albert828/Sterowniki-robotow-P/README.md

# Remote control robot
> Type (1,1) robot controled by smartphone using WiFi newtork.

## Table of contents
* [General info](#general-info)
* [Technologies](#technologies)
* [Libraries](#libraries)
* [Features](#features)
* [Documentation](#documentation)
* [Status](#status)
* [Contact](#contact)
* [Contributors](#contributors)

## General info
The robot was created as university project in the subject of Robot Controllers.

## Technologies
* C
* STM32
* Arduino

## Libraries
* STM32 HAL

## Features
### Completed
- Build a remote-controlled robot.
- Smartphone gyro control.
- Stabilization of the speed of movement by PID controller and encoders
- Implementation of communication beetwen controller and WiFi module
- Implementation of communication beetwen WiFi module and smartphone
### Unrealized
- Stabilization of the speed of movement by PID controller due to the low precision of the encoders

## Documentation
[Docs](./Etap%203/SteRoP_2019_HURA_ALMM_3/SteRoP_2019_HURA_ALMM_3.pdf)

## Status
Project is: _finished_

## Contact
albert.lis.1996@gmail.com - feel free to contact me!

## Contributors
[Albert Lis](https://github.com/albertlis) [MichalMorun](https://github.com/MichalMorun)
