albert828/Sterowniki-robotow-P/Etap 2/SteRoP_2019_HURA_ALMM_2/SteRoP_2019_HURA_ALMM_2.tex

% !TeX encoding = UTF-8
% !TeX spellcheck = pl_PL

% $Id:$

%Author: Wojciech Domski
%Szablon do ząłożeń projektowych, raportu i dokumentacji z steorwników robotów
%Wersja v.1.0.0
%

%% Konfiguracja:
\newcommand{\kurs}{Sterowniki robot\'{o}w}
\newcommand{\formakursu}{Projekt}

%odkomentuj właściwy typ projektu, a pozostałe zostaw zakomentowane
%\newcommand{\doctype}{Za\l{}o\.{z}enia projektowe} %etap I
\newcommand{\doctype}{Raport} %etap II
%\newcommand{\doctype}{Dokumentacja} %etap III

%wpisz nazwę projektu
\newcommand{\projectname}{Humanistycznie upo\'sledzony robot akrobatyczny}

%wpisz akronim projektu
\newcommand{\acronim}{HURA}

%wpisz Imię i nazwisko oraz numer albumu
\newcommand{\osobaA}{Albert \textsc{Lis}, 235534}
%w przypadku projektu jednoosobowego usuń zawartość nowej komendy
\newcommand{\osobaB}{Micha\l{} \textsc{Moru\'n}, 235986}

%wpisz termin w formie, jak poniżej dzień, parzystość, godzina
\newcommand{\termin}{sr TP15 }

%wpisz imię i nazwisko prowadzącego
\newcommand{\prowadzacy}{mgr in\.{z}. Wojciech \textsc{Domski}}

\documentclass[10pt, a4paper]{article}

\include{preambula}
	
\begin{document}

\def\tablename{Tabela}	%zmienienie nazwy tabel z Tablica na Tabela

\begin{titlepage}
	\begin{center}
		\textsc{\LARGE \formakursu}\\[1cm]		
		\textsc{\Large \kurs}\\[0.5cm]		
		\rule{\textwidth}{0.08cm}\\[0.4cm]
		{\huge \bfseries \doctype}\\[1cm]
		{\huge \bfseries \projectname}\\[0.5cm]
		{\huge \bfseries \acronim}\\[0.4cm]
		\rule{\textwidth}{0.08cm}\\[1cm]
		
		\begin{flushright} \large
		\emph{Skład grupy:}\\
		\osobaA\\
		\osobaB\\[0.4cm]
		
		\emph{Termin: }\termin\\[0.4cm]

		\emph{Prowadzący:} \\
		\prowadzacy \\
		
		\end{flushright}
		
		\vfill
		
		{\large \today}
	\end{center}	
\end{titlepage}

\newpage
\tableofcontents
\newpage

%Obecne we wszystkich dokumentach
\section{Opis projektu}
\label{sec:OpisProjektu}

Celem projektu jest zbudowanie zdalnie sterowanego robota jezdnego. Robot będzie sterowany za pomocą akcelerometru w telefonie. Dane będą przesyłanie za pomocą Wi-Fi lub Bluetooth. Regulacja prędkości będzie się odbywać za pomocą regulatora PID. Dane o prędkości będą pobierane z enkoderów znajdujących się w kołach robota. Opcjonalnie robot będzie wyświetlał szczegółowe dane o swoim stanie wewnętrznym za pomocą wbudowanego w płytkę z mikrokontrolerem wyświetlacza LCD.
\newline
\newline

\begin{figure}[H]
	\centering
	
	\caption{Architektura systemu}
	\label{fig:Architektura}
\end{figure}

%Obecne we wszystkich dokumentach
\section{Konfiguracja mikrokontrolera}

\begin{figure}[H]
	\centering
	
	\caption{Konfiguracja wyjść mikrokontrolera w programie STM32CubeMX}
	\label{fig:KonfiguracjaMikrokontrolera}
\end{figure}

\newpage
\begin{figure}[H]
	\centering
	
	\caption{Konfiguracja zegarów mikrokontrolera}
	\label{fig:KonfiguracjaZegara}
\end{figure}

%Obecne we wszystkich dokumentach
\subsection{Konfiguracja pinów}

\begin{table}[H]
	\centering
	\begin{tabular}{|l|l|l|l|}
		\hline
		PIN & Tryb pracy & Funkcja/etykieta\\
		\hline
		PC14 & OSC32\_IN*	RCC\_OSC32\_IN	&\\
		PC15 & OSC32\_OUT*	RCC\_OSC32\_OUT	&\\
		PH0&  OSC\_IN*	RCC\_OSC\_IN	&\\
		PH1&  OSC\_OUT*&		RCC\_OSC\_OUT	\\
		PD5&	USART2\_TX&	USART\_TX\\
		PD6&	USART2\_RX&	USART\_RX\\
		%PE11&	TIM1\_CH2&	PWM\_SERVO\\
		PA0&	ADC1\_IN5&	PWM\_INPUT\\
		PA1&	GPIO\_Input&	JOY\_LEFT\\
		PA2&	GPIO\_Input&	JOY\_RIGHT\\
		PA3&	GPIO\_Input&	JOY\_UP\\
		PA4& GPIO\_Input& JOY\_DOWN\\
		PA5&	TIM2\_CH1&	PWM\_MOTOR\\
		PB7&    TIM4\_CH2&	PWM\_SERVO\\

		\hline
	\end{tabular}
	\caption{Konfiguracja pinów mikrokontrolera}
\end{table}

%Obecne we wszystkich dokumentach
\subsection{ADC 1}

\begin{table}[H]
	\centering
	\begin{tabular}{|l|c|} \hline
		\textbf{Parametr} & Wartość \\
		\hline
		\hline  \textbf{Resolution}&ADC 12-bit resolution  \\\hline
		\textbf{DMA Continuous Requests} & \textcolor{blue}{Enabled}\\\hline
		\textbf{Data Alignment} &  Right alignment\\
		\hline
		\textbf{Continuous Conversion Mode}& Disabled\\
		\hline
		\textbf{Channel}& Channel 5\\
		\hline
		\textbf{Sampling Time}& \textcolor{blue}{92.5 Cycles}\\
		\hline
	\end{tabular}
	\caption{Konfiguracja peryferium ADC}
	\label{tab:ADC}
\end{table}

\subsection{Timer 2}

\begin{table}[H]
	\centering
	\begin{tabular}{|l|c|} \hline
		\textbf{Parametr} & Wartość \\
		\hline
		\hline  \textbf{Clock Source}&Internal Clock  \\\hline
		\textbf{Channel1} & PWM Generation CH1\\\hline
		\textbf{Prescaler} & \textcolor{blue}{PWM\_PRESC}\\\hline
		\textbf{Counter Mode} &  Up\\
		\hline
		\textbf{Counter Period}& \textcolor{blue}{PWM\_PERIOD}\\\hline
		\textbf{Internal Clock Division}& No Division\\
		\hline
		\textbf{Mode}& PWM mode 1\\
		\hline
		\textbf{CH Polarity}& High\\
		\hline
	\end{tabular}
	\caption{Konfiguracja peryferium Timer 2}
	\label{tab:Timer2}
\end{table}

\subsection{Timer 4}

\begin{table}[H]
	\centering
	\begin{tabular}{|l|c|} \hline
		\textbf{Parametr} & Wartość \\
		\hline
		\hline  \textbf{Clock Source}&Internal Clock  \\\hline
		\textbf{Channel} & PWM Generation CH2\\\hline
		\textbf{Prescaler} & \textcolor{blue}{999}\\\hline
		\textbf{Counter Mode} &  Up\\
		\hline
		\textbf{Counter Period}& \textcolor{blue}{999}\\\hline
		\textbf{Internal Clock Division}& No Division\\
		\hline
		\textbf{Mode}& PWM mode 1\\
		\hline
		\textbf{CH Polarity}& High\\
		\hline
	\end{tabular}
	\caption{Konfiguracja peryferium Timer 4}
	\label{tab:Timer4}
\end{table}

\subsection{Timer 6}

\begin{table}[H]
	\centering
	\begin{tabular}{|l|c|} \hline
		\textbf{Parametr} & Wartość \\
		\hline
		\hline
		\textbf{Prescaler} & \textcolor{blue}{TIM6\_PRESC}\\\hline
		\textbf{Counter Mode} &  Up\\
		\hline
		\textbf{Counter Period}& \textcolor{blue}{TIM6\_PERIOD}\\\hline
		\textbf{Trigger Event Selection}& \textcolor{blue}{Update Event}\\
		\hline
	\end{tabular}
	\caption{Konfiguracja peryferium Timer 6}
	\label{tab:Timer6}
\end{table}
%Obecne w dokumencie do etapu II oraz III
%\section{Urządzenia zewnętrzne}
%\textcolor{red}{Rozdział ten powinien zawierać opis i konfigurację %wykorzystanych ukladów
%	zewnętrznych, jak np. akcelerometr.}

%Obecne w dokumencie do etapu II oraz III
\section{Projekt elektroniki}
	\subsection{Schemat elektryczny}
	\begin{figure}[H]
		\centering
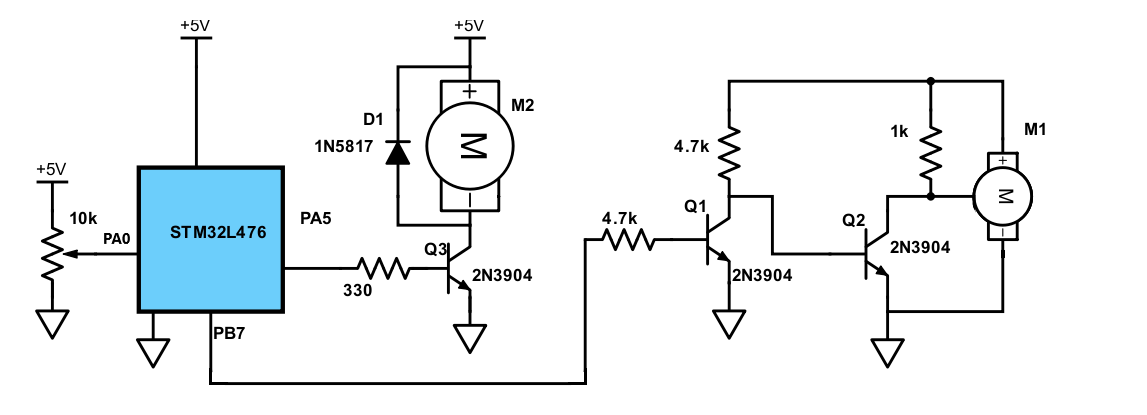
[picture p12: Etap 2/SteRoP_2019_HURA_ALMM_2/figures/schemeit-project.png]
		
		\caption{Schemat elektryczny}
		\label{fig:Schemat elektryczny}
	\end{figure}
	
\subsection{Regulacja prędkości napędu}
Za pomocą potencjometru regulujemy wypełnienie sygnału PWM. Sygnał ten jest wzmacniany za pomocą tranzystora NPN i przekazywany do silnika DC.

\begin{figure}[H]
	\centering
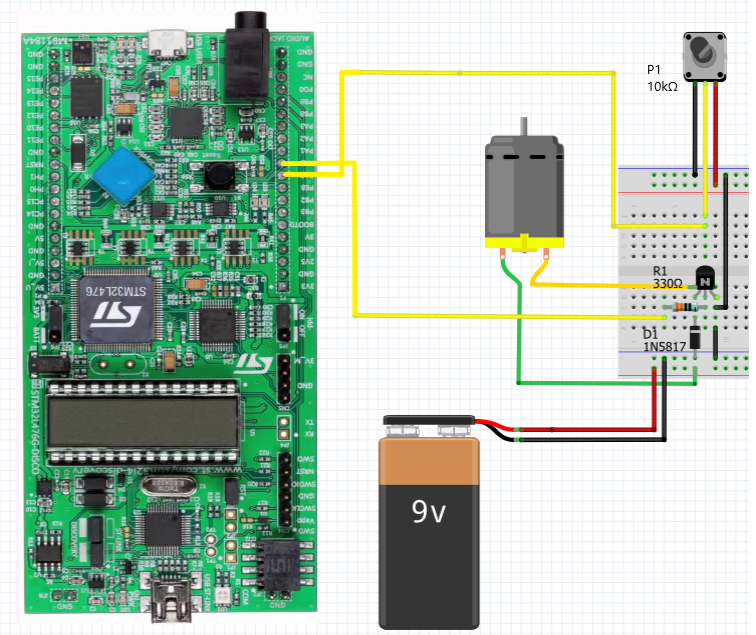
[picture p13: Etap 2/SteRoP_2019_HURA_ALMM_2/figures/pwm.png]
	
	\caption{Schemat poglądowy regulacji prędkości obrotowej silnika}
	\label{fig:KonfiguracjaPWM}
\end{figure}

%Obecne w dokumencie do etapu II oraz III
\section{Konstrukcja mechaniczna}

	\begin{figure}[H]
		\centering
		
		\caption{Zdjęcie części mechanicznej nr 1}
		\label{fig:Zdjęcie części mechanicznej nr 1}
	\end{figure}
	
		\begin{figure}[H]
		\centering
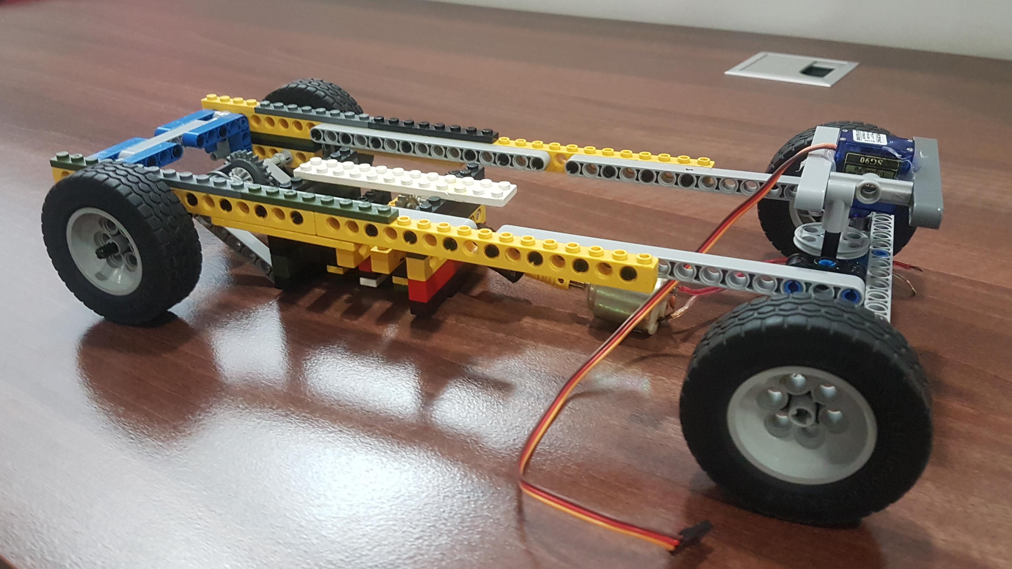
[picture p14: Etap 2/SteRoP_2019_HURA_ALMM_2/figures/20190410_135853.jpg]
		
		\caption{Zdjęcie części mechanicznej nr 2}
		\label{fig:Zdjęcie części mechanicznej nr 2}
	\end{figure}

%Obecne w dokumencie do etapu II oraz III
\section{Opis działania programu}

\subsection{Schemat działania programu}
	\begin{figure}[H]
		\centering
		
		\caption{Schemat działania programu}
		\label{fig:diagramPWM}
	\end{figure}

\subsection{Funkcja obsługująca przerwanie timera 6}
	\begin{lstlisting}[tabsize=2]
	void HAL_TIM_PeriodElapsedCallback(TIM_HandleTypeDef *htim)
	{
		if(htim->Instance == TIM6)
			HAL_ADC_Start_DMA(&hadc1, (uint32_t *)&adc_value, 1);
	}
	\end{lstlisting}

\subsection{Funkcja obsługująca przerwanie ADC}
\begin{lstlisting}[tabsize=2]
void HAL_ADC_ConvCpltCallback(ADC_HandleTypeDef* hadc)
{
	//pid_output = pid_calc(&pid, adc_value, set_value);
	__HAL_TIM_SET_COMPARE(&htim2 , TIM_CHANNEL_1, adc_value);
}
\end{lstlisting}

%Obecne w dokumencie do etapu II oraz III (jeśli coś zostało niezrealizowane)
\section{Zadania niezrealizowane}
Nie zostało zrealizowane przekazanie napędu z silnika i serwomechanizmu na mechanizm napędowy oraz na ten służący do skręcania. W pierwszym przypadku jest to spowodowane brakiem czasu, wynikający ze zbyt długim poszukiwaniem rozwiązania na problem przeniesienia napędu z silnika do przekładni, natomiast w drugim tym, że wał serwomechanizmu ma stępione zębatki co uniemożliwia przekazanie jakiejkolwiek siły na dalszy podzespół.

%Obecne we wszystkich dokumentach
\section{Podsumowanie}

Udało się zrealizować większość zadań. Nastąpiły drobne zmiany koncepcyjne jak użycie potencjometru do regulacji prędkości obrotowej napędu. To będzie wymagać mniejszej ingerencji gdy będziemy projektować regulator PID.

\newpage
\addcontentsline{toc}{section}{Bibilografia}
\bibliography{bibliografia}
\bibliographystyle{plabbrv}

\end{document}
