albert828/Sterowniki-robotow-P/Etap 3/SteRoP_2019_HURA_ALMM_3/SteRoP_2019_HURA_ALMM_3.pdf

Projekt

Sterowniki robotów

# Dokumentacja

# Humanistycznie upośledzony robot akrobatyczny

# HURA

Skład grupy:
Albert Lis, 235534
Michał Moruń, 235986

Termin: sr TP15

Prowadzący:
mgr inż. Wojciech Domski

5 czerwca 2019

## Spis treści

1 Opis projektu | 2
2 Konfiguracja mikrokontrolera | 3
3 Urządzenia zewnętrzne | 6
4 Projekt elektroniki | 7
5 Konstrukcja mechaniczna | 9
6 Regulator PID | 11
7 Opis działania programu | 11
8 Podsumowanie | 13
Bibilografia | 14

## 1 Opis projektu

Celem projektu jest zbudowanie zdalnie sterowanego robota jezdnego. Robot będzie sterowany za pomocą akcelerometru w telefonie. Dane będą przesyłanie za pomocą Wi-Fi lub Bluetooth. Regulacja prędkości będzie się odbywać za pomocą regulatora PID. Dane o prędkości będą pobierane z enkoderów znajdujących się w kołach robota. Opcjonalnie robot będzie wyświetlał szczegółowe dane o swoim stanie wewnętrznym za pomocą wbudowanego w płytkę z mikrokontrolerem wyświetlacza LCD.


Rysunek 1: Architektura systemu

## 2 Konfiguracja mikrokontrolera


Rysunek 2: Konfiguracja wyjść mikrokontrolera w programie STM32CubeMX

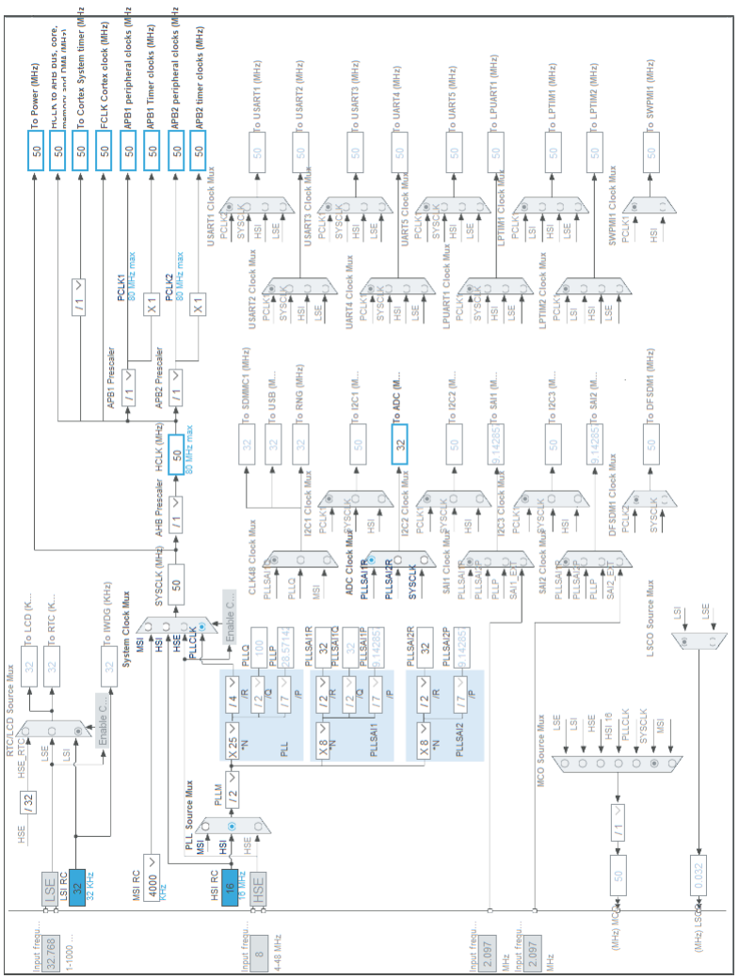
[picture p18: figure]

Rysunek 3: Konfiguracja zegarów mikrokontrolera

### 2.1 Konfiguracja pinów

PIN | Tryb pracy | Funkcja/etykieta
PC14 PC15 PH0 PH1 PA2 PA3 PA0 PA5 PB6 | OSC32_IN* RCC_OSC32_IN OSC32_OUT* RCC_OSC32_OUT OSC_IN* RCC_OSC_IN OSC_OUT* USART2_TX USART2_RX TIM5 CH1 TIM2_CH1 TIM4_CH1 | RCC_OSC_OUT USART_TX USART_RX ENCODER_P DO_PRZODU SERVO

Tabela 1: Konfiguracja pinów mikrokontrolera

### 2.2 USART

Interfejs jest wykorzystywany do komunikacji z modułem Wi-Fi (ESP8266). Moduł odbiera dane za pomocą interfejsu UDP i przekazuje je do mikrokontrolera STM32 za pomocą interfejsu komunikacji szeregowej.

Parametr | Wartość
Baud Rate | 115200
Word Length | 8 Bits (including parity)
Parity | None
Stop Bits | 1

Tabela 2: Konfiguracja peryferium USART

### 2.3 Timer 2

Parametr | Wartość
Clock Source | Internal Clock
Channel1 | PWM Generation CH1
Prescaler | TIM2_PRESC
Counter Mode | Up
Counter Period | TIM2_PERIOD
Internal Clock Division | No Division
Mode | PWM mode 1
CH Polarity | High

Tabela 3: Konfiguracja peryferium Timer 2

### 2.4 Timer 4

Parametr | Wartość
Clock Source | Internal Clock
Channel | PWM Generation CH1
Prescaler | TIM4_PRESC
Counter Mode | Up
Counter Period | TIM4_PERIOD
Internal Clock Division | No Division
Mode | PWM mode 1
CH Polarity | High

Tabela 4: Konfiguracja peryferium Timer 4

### 2.5 Timer 5

Parametr | Wartość
Clock Source | Internal Clock
Channel | Input Capture direct mode
Prescaler | TIM5_PRESC
Counter Mode | Up
Counter Period | TIM5_PERIOD
Internal Clock Division | No Division

Tabela 5: Konfiguracja peryferium Timer 6

## 3 Urządzenia zewnętrzne

### 3.1 Moduł Wi-Fi ESP8266

Moduł dobiera dane za pomocą protokołu UDP i przekazuje je odpowiednio sformatowane za pomocą portu szeregowego do mikrokontrolera STM32. Do oprogramowania modułu wykorzystano framework Arduino.
Ustawienia komunikacji szeregowej:
Parametr | Wartość
Baud Rate | 115200
Word Length | 8 Bits (including parity)
Parity | None
Stop Bits | 1

Tabela 6: Konfiguracja peryferium UART w module Wi-Fi

### 3.2 Smartfon z aplikacją RoboRemo

Przesyła wartości osi X i Y żyroskopu za pomocą protokołu UDP. Ustawienia żyroskopu w aplikacji:

Parametr | Wartość
Etykieta | x
Wzmocnienie | 1.0
Typ danych | int
Zakres | od -255 do 255
Limit do [min:max] | tak

Tabela 7: Konfiguracja osi X

Parametr | Wartość
Etykieta | y
Wzmocnienie | 0.5
Typ danych | int
Zakres | od 50 do 150
Limit do [min:max] | tak

Tabela 8: Konfiguracja osi Y

## 4 Projekt elektroniki

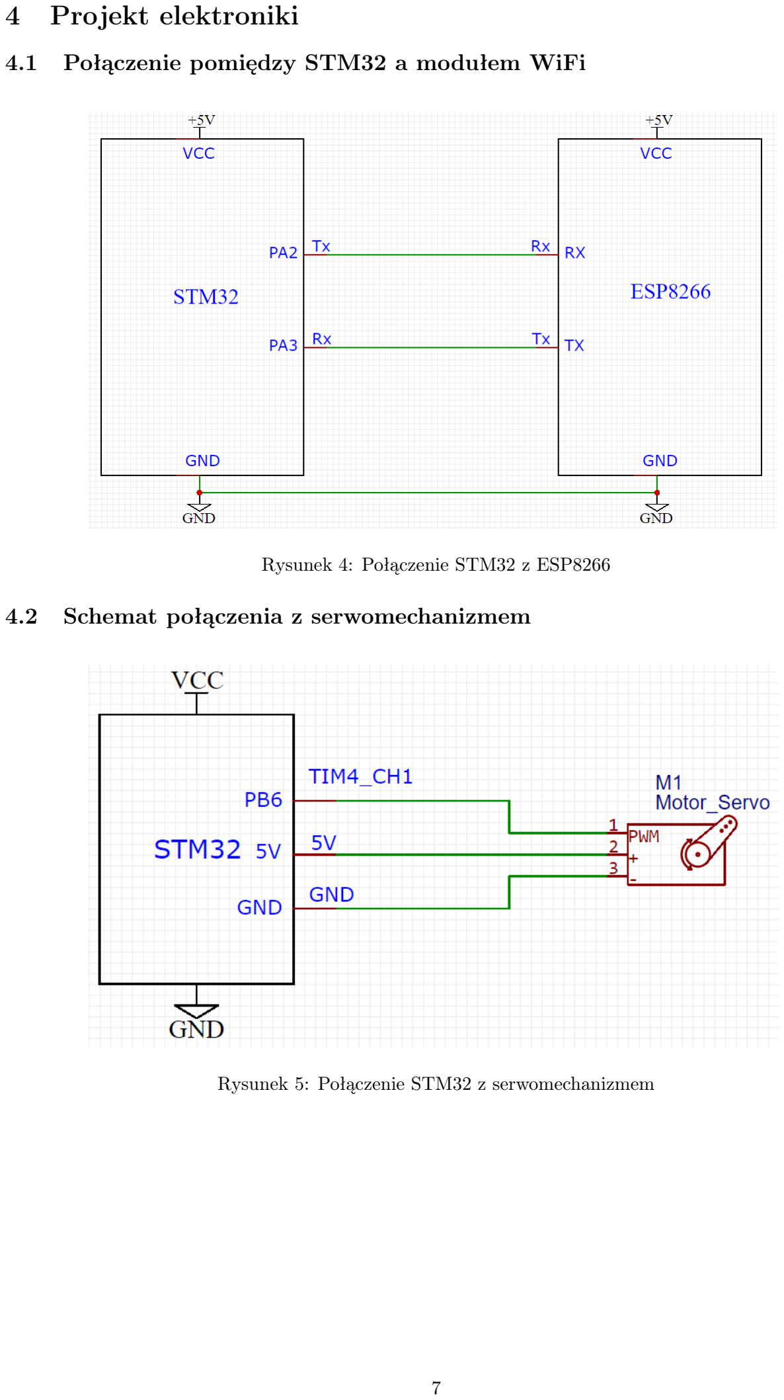
[picture p19: page 8]

### 4.1 Połączenie pomiędzy STM32 a modułem WiFi

Rysunek 4: Połączenie STM32 z ESP8266

### 4.2 Schemat połączenia z serwomechanizmem

Rysunek 5: Połączenie STM32 z serwomechanizmem

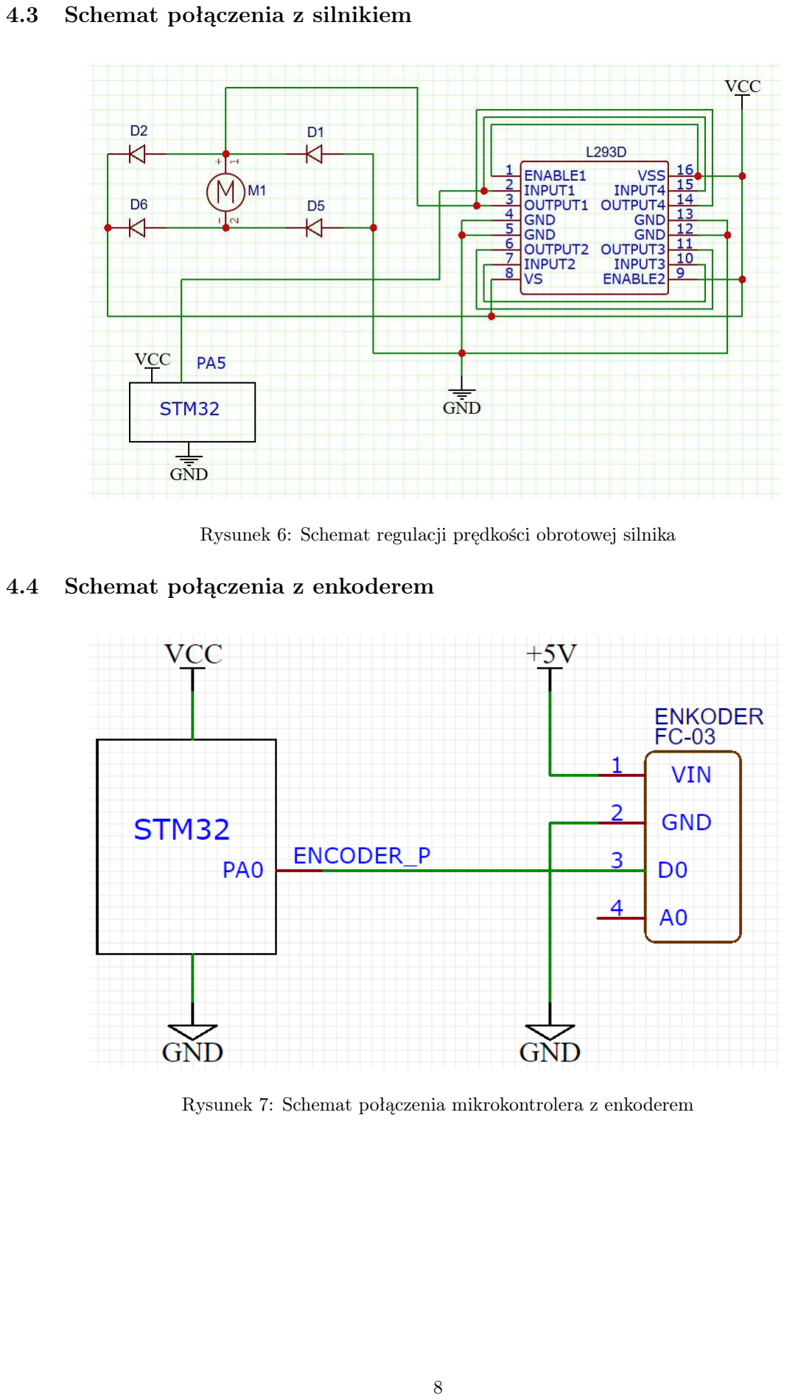
[picture p20: page 9]

### 4.3 Schemat połączenia z silnikiem

Rysunek 6: Schemat regulacji prędkości obrotowej silnika

### 4.4 Schemat połączenia z enkoderem

Rysunek 7: Schemat połączenia mikrokontrolera z enkoderem

## 5 Konstrukcja mechaniczna

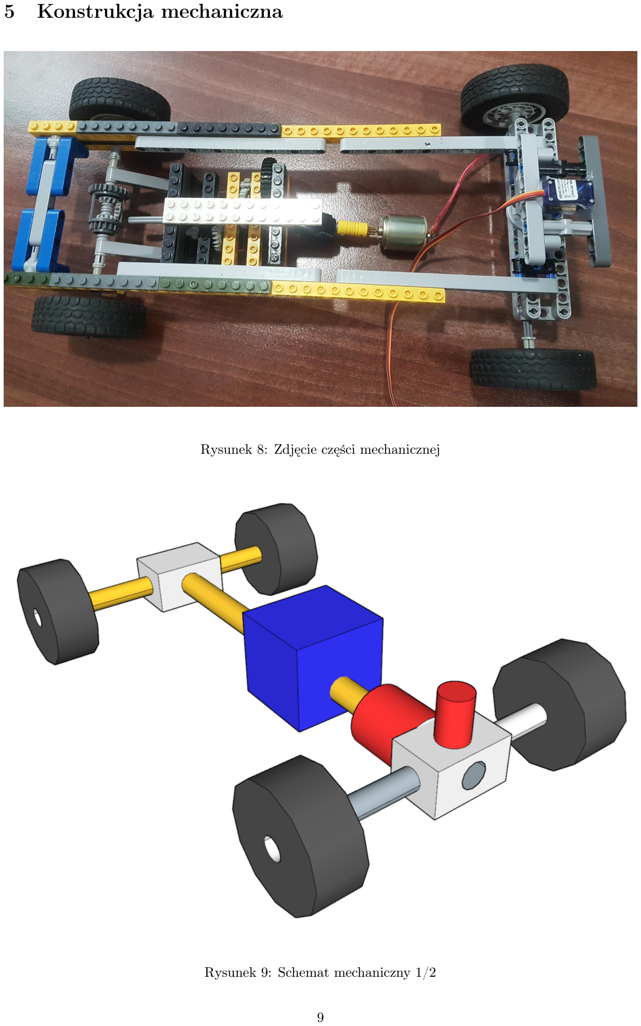
[picture p21: page 10]

Rysunek 8: Zdjęcie części mechanicznej

Rysunek 9: Schemat mechaniczny 1/2

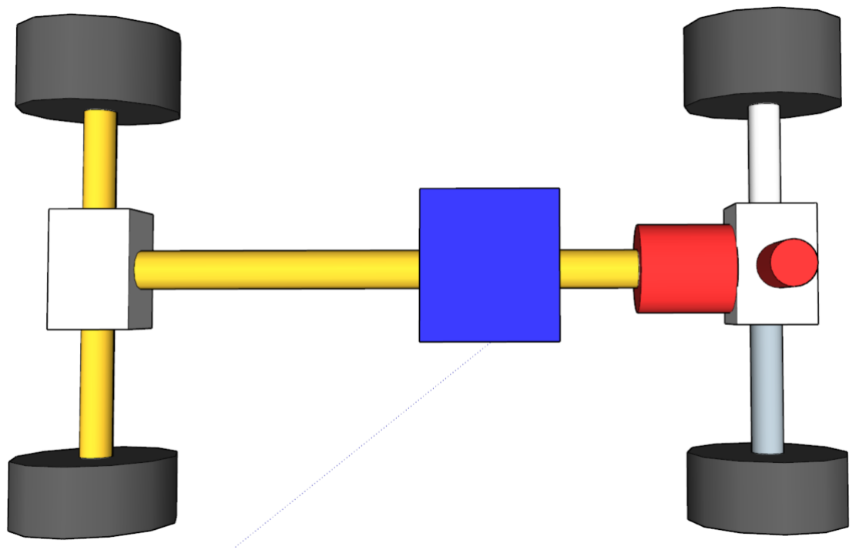
[picture p22: figure]

Rysunek 10: Schemat mechaniczny 2/2

Kolor | Opis
Czerwony | Silniki
Niebieski | Przekładnia
Żółty | Elementy przeniesienia napędu

Tabela 9: Legenda

## 6 Regulator PID

### 6.1 Wykres odpowiedzi skokowej


Rysunek 11: Odpowiedz skokowa

Na wykresie występują bardzo duże oscylacje, które są spowodowane niedoskonałością wykonanego mechanizmu różnicowego oraz zbyt małą rozdzielczością odczytów z enkoderów. W związku z tym od-powiedź skokową przybliżono linią trendu i na jej podstawie za pomocą II metody Zieglera - Nicholsa wyliczono parametry Kp, Ki oraz Kd.

### 6.2 Wyznaczenie parametrów PID

k = ∆wy/∆we =

0.01923
0.01515 = 1.2693 ≈ 1.27

Kp = 0.6 ∗ k = 0.762
Ki = 2 ∗

Kp
Pu

= 1.879
Kd =

Kp∗Pu
8 = 0.086

## 7 Opis działania programu

### 7.1 Schemat działania programu

Rysunek 12: Schemat działania programu

### 7.2 Ręczna inicjalizacja parametrów w funkcji main

1 | f l a g 1 = f l a g 2 = 0 ;
2 | pwm_dutyL = pwm_dutyP = 0 ;
3 | HAL_TIM_IC_Start_IT(&htim5 , TIM_CHANNEL_1) ;
4 | HAL_TIM_IC_Start_IT(&htim5 , TIM_CHANNEL_2) ;
5

6 | HAL_TIM_PWM_Start(&htim4 , TIM_CHANNEL_1) ;
7 | HAL_TIM_PWM_Start(&htim2 , TIM_CHANNEL_1) ;
8 | HAL_TIM_PWM_Start(&htim2 , TIM_CHANNEL_2) ;
9
10 | HAL_UART_Receive_DMA(&huart2 , &Received , BUFSIZE) ;
11 | P ID Ini t (&pid , kp , ki , kd , sampleTimeSeconds , minOutput , maxOutput , mode , c o n t r o l
| ) ;
12 | P IDSe tp oin tSe t (&pid , se t_ v alue ) ;
13 | PIDInputSet(&pid , speed ) ;

### 7.3 Funkcja obsługująca Input Capture

1 | i n t speed ;
2 | v oid HAL_TIM_IC_CaptureCallback ( TIM_HandleTypeDef ∗htim )
3 | {
4 | i f ( htim == &htim5 )
5 | {
6 | i f ( htim−>Channel == HAL_TIM_ACTIVE_CHANNEL_1)
7 | {
8 | p e ri o d 1 = __HAL_TIM_GET_COMPARE(&htim5 , TIM_CHANNEL_1) ;
9 | __HAL_TIM_SET_COUNTER(&htim5 , 0 ) ;
10 | f l a g 1 = 1 ;
11 | speed = ( p e ri o d 1 <= 5 0 ) ? ( 2 5 5 − map( pe ri od 1 , 2 0 , 5 0 , 0 , 2 5 5 ) ) : 0 ;
12 | }
13 | sampleTimeSeconds = p e ri o d 1 / 1 0 0 0 . 0 ;
14 | P ID Ini t (&pid , kp , ki , kd , sampleTimeSeconds , minOutput , maxOutput , mode ,
| c o n t r o l ) ;
15 | }
16 | }

### 7.4 Funkcja obsługująca przerwanie USART

1 | v o l a t i l e uint8_t xvalue , yvalue , y p r e vi o u s , x p r e vi o u s ;
2 | v o l a t i l e ch a r x si g n ;
3 | v oid HAL_UART_RxCpltCallback (UART_HandleTypeDef ∗ hu a r t )
4 | {
5 | a x i s = ( ch a r ) ( Received [ n rAxi s ] ) ;
6 | si g n = ( ch a r ) ( Received [ n rSi gn ] ) ;
7 | v al u e = ( uint8_t ) ( Received [ nrValue ] ) ;
8
9 | i f ( a x i s == ' x ' )
10 | {
11 | x si g n = si g n ;
12 | x p r e vi o u s = x v alue ;
13 | x v alue = v al u e ;
14 | }
15
16 | i f ( a x i s == ' y ' )
17 | {
18 | y p r e vi o u s = y v alue ;
19 | y v alue = v al u e ;
20 | i f ( abs ( v al u e − x p r e vi o u s ) < 2 )
21 | y v alue = y p r e vi o u s ;
22 | e l s e i f ( v al u e > 1 0 0 )
23 | y v alue = y p r e vi o u s ;
24 | e l s e i f ( v al u e < 5 0 )
25 | y v alue = y p r e vi o u s ;
26 | }
27 | P IDSe tp oin tSe t (&pid , se t_ v alue ) ;
28 | PIDInputSet(&pid , speed ) ;
29 | PIDCompute(& pid ) ;
30 | pid_output = PIDOutputGet(& pid ) ;
31 | HAL_UART_Receive_DMA(&huart2 , &Received , BUFSIZE) ;
32 | }

### 7.5 Funkcja realizująca jazdę

1 | v oid Jazda ( )
2 | {
3 | __HAL_TIM_SET_COMPARE(&htim2 , TIM_CHANNEL_1, 255 − pid_output ) ;
4 | }

### 7.6 Funkcja realizująca skręcanie

1 | v oid S k r e c a ni e ( )
2 | {
3 | __HAL_TIM_SET_COMPARE(&htim4 , TIM_CHANNEL_1, y v alue ) ;
4 | }

### 7.7 Funkcja mapująca wartości czasowe na wartość zadaną regulatora PID

1 | l o n g map( l o n g x , l o n g in_min , l o n g in_max , l o n g out_min , l o n g out_max )
2 | {
3 | r e t u r n ( x − in_min ) ∗ ( out_max − out_min ) / (in_max − in_min ) + out_min ;
4 | }

### 7.8 Funkcja przekierowująca printf()

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

### 7.9 Pętla główna

1 | w hil e ( 1 )
2 | {
3 | Jazda ( ) ;
4 | S k r e c a ni e ( ) ;
5 | }

## 8 Podsumowanie

| Udało się zrealizować wszystkie założenia projektowe. Jedynym elementem w projekcie, który mógłby
| być lepszy to kółko szczerbinkowe na osi o większej ilości dziurek, aby zwiększyć rozdzielczość odczytów
| z enkoderów przez co działanie regulatora PID byłoby bardziej płynne i dokładne.

## Literatura

[1] Krzysztof Amborski, Andrzej Murusak: Teoria sterowania w ćwiczeniach, (’78)
[2] Józef Lisowski: Podstawy automatyki, (2015)
[3] Jerzy Brzózka: Regulatory i układy automatyki, (2004)
[4] Krzysztof Tchoń: Manipulatory i roboty mobilne : modele, planowanie ruchu, sterowanie, (2000)
[5] Stanisław Wszelak: Administrowanie sieciowymi protokołami komunikacyjnymi, (2015)
