albert828/Sterowniki-robotow-P/Etap 2/SteRoP_2019_HURA_ALMM_2/Sterowniki_robotow_P.pdf

Projekt

Sterowniki robotów

# Raport

# Humanistycznie upośledzony robot akrobatyczny

# HURA

Skład grupy:
Albert Lis, 235534
Michał Moruń, 235986

Termin: sr TP15

Prowadzący:
mgr inż. Wojciech Domski

10 kwietnia 2019

## Spis treści

1 Opis projektu | 2
2 Konfiguracja mikrokontrolera | 3
3 Projekt elektroniki | 6
4 Konstrukcja mechaniczna | 7
5 Opis działania programu | 8
6 Zadania niezrealizowane | 8
7 Podsumowanie | 9
Bibilografia | 10

## 1 Opis projektu

Celem projektu jest zbudowanie zdalnie sterowanego robota jezdnego. Robot będzie sterowany za pomocą akcelerometru w telefonie. Dane będą przesyłanie za pomocą Wi-Fi lub Bluetooth. Regulacja prędkości będzie się odbywać za pomocą regulatora PID. Dane o prędkości będą pobierane z enkoderów znajdujących się w kołach robota. Opcjonalnie robot będzie wyświetlał szczegółowe dane o swoim stanie wewnętrznym za pomocą wbudowanego w płytkę z mikrokontrolerem wyświetlacza LCD.


Rysunek 1: Architektura systemu

## 2 Konfiguracja mikrokontrolera


Rysunek 2: Konfiguracja wyjść mikrokontrolera w programie STM32CubeMX


Rysunek 3: Konfiguracja zegarów mikrokontrolera

### 2.1 Konfiguracja pinów

PIN | Tryb pracy | Funkcja/etykieta
PC14 PC15 PH0 PH1 PD5 PD6 PA0 PA1 PA2 PA3 PA4 PA5 PB7 | OSC32_IN* RCC_OSC32_IN OSC32_OUT* RCC_OSC32_OUT OSC_IN* RCC_OSC_IN OSC_OUT* USART2_TX USART2_RX ADC1_IN5 GPIO_Input GPIO_Input GPIO_Input GPIO_Input TIM2_CH1 TIM4_CH2 | RCC_OSC_OUT USART_TX USART_RX PWM_INPUT JOY_LEFT JOY_RIGHT JOY_UP JOY_DOWN PWM_MOTOR PWM_SERVO

Tabela 1: Konfiguracja pinów mikrokontrolera

### 2.2 ADC 1

Parametr | Wartość
Resolution | ADC 12-bit resolution
DMA Continuous Requests | Enabled
Data Alignment | Right alignment
Continuous Conversion Mode | Disabled
Channel | Channel 5
Sampling Time | 92.5 Cycles

Tabela 2: Konfiguracja peryferium ADC

### 2.3 Timer 2

Parametr | Wartość
Clock Source | Internal Clock
Channel1 | PWM Generation CH1
Prescaler | PWM_PRESC
Counter Mode | Up
Counter Period | PWM_PERIOD
Internal Clock Division | No Division
Mode | PWM mode 1
CH Polarity | High

Tabela 3: Konfiguracja peryferium Timer 2

### 2.4 Timer 4

Parametr | Wartość
Clock Source | Internal Clock
Channel | PWM Generation CH2
Prescaler | 999
Counter Mode | Up
Counter Period | 999
Internal Clock Division | No Division
Mode | PWM mode 1
CH Polarity | High

Tabela 4: Konfiguracja peryferium Timer 4

### 2.5 Timer 6

Parametr | Wartość
Prescaler | TIM6_PRESC
Counter Mode | Up
Counter Period | TIM6_PERIOD
Trigger Event Selection | Update Event

Tabela 5: Konfiguracja peryferium Timer 6

## 3 Projekt elektroniki

### 3.1 Schemat elektryczny

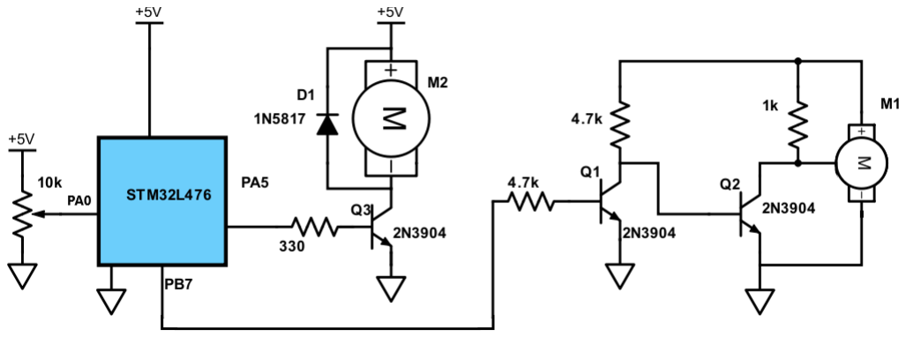
[picture p23: figure]

Rysunek 4: Schemat elektryczny

### 3.2 Regulacja prędkości napędu

Za pomocą potencjometru regulujemy wypełnienie sygnału PWM. Sygnał ten jest wzmacniany za pomocą tranzystora NPN i przekazywany do silnika DC.

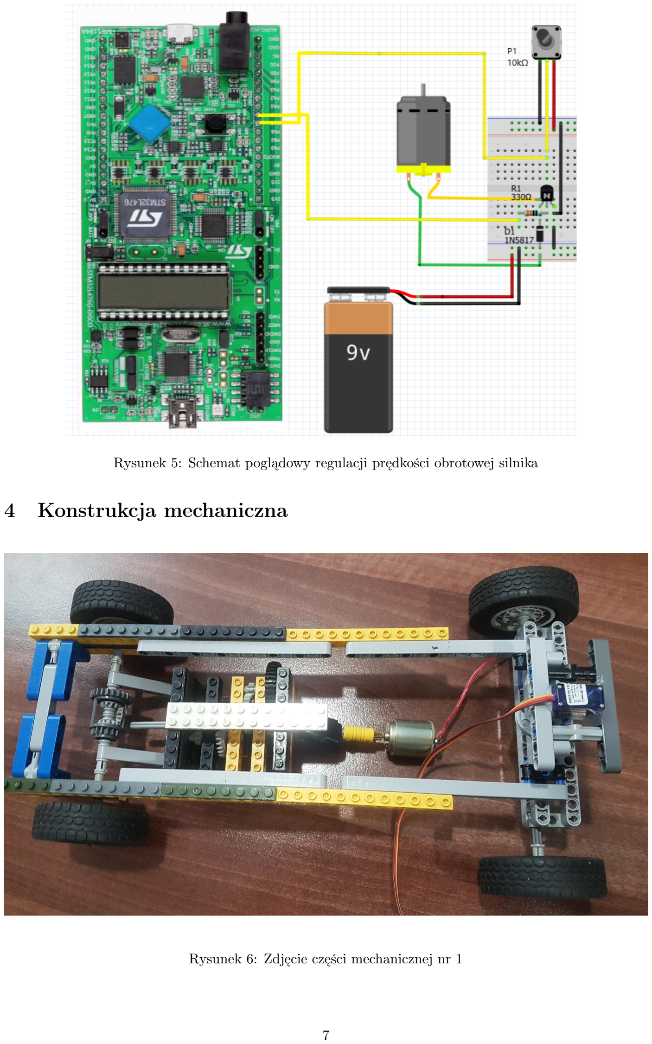
[picture p24: page 8]

Rysunek 5: Schemat poglądowy regulacji prędkości obrotowej silnika

## 4 Konstrukcja mechaniczna

Rysunek 6: Zdjęcie części mechanicznej nr 1


Rysunek 7: Zdjęcie części mechanicznej nr 2

## 5 Opis działania programu

### 5.1 Schemat działania programu

Rysunek 8: Schemat działania programu

### 5.2 Funkcja obsługująca przerwanie timera 6

1 | v oid HAL_TIM_PeriodElapsedCallback ( TIM_HandleTypeDef ∗htim )
2 | {
3 | i f ( htim−>I n s t a n c e == TIM6)
4 | HAL_ADC_Start_DMA(&hadc1 , ( uint32_t ∗)&adc_value , 1 ) ;
5 | }

### 5.3 Funkcja obsługująca przerwanie ADC

1 | v oid HAL_ADC_ConvCpltCallback (ADC_HandleTypeDef∗ hadc )
2 | {
3 | // pid_output = pid_c alc (&pid , adc_value , se t_ v alue ) ;
4 | __HAL_TIM_SET_COMPARE(&htim2 , TIM_CHANNEL_1, adc_value ) ;
5 | }

## 6 Zadania niezrealizowane

| Nie zostało zrealizowane przekazanie napędu z silnika i serwomechanizmu na mechanizm napędowy
| oraz na ten służący do skręcania. W pierwszym przypadku jest to spowodowane brakiem czasu, wynika-
| jący ze zbyt długim poszukiwaniem rozwiązania na problem przeniesienia napędu z silnika do przekładni,
| natomiast w drugim tym, że wał serwomechanizmu ma stępione zębatki co uniemożliwia przekazanie
| jakiejkolwiek siły na dalszy podzespół.

## 7 Podsumowanie

Udało się zrealizować większość zadań. Nastąpiły drobne zmiany koncepcyjne jak użycie potencjometru do regulacji prędkości obrotowej napędu. To będzie wymagać mniejszej ingerencji gdy będziemy projektować regulator PID.

## Literatura
