albert828/Sterowniki-robotow-P/Etap 3/SteRoP_2019_HURA_ALMM_3/figures/3.png

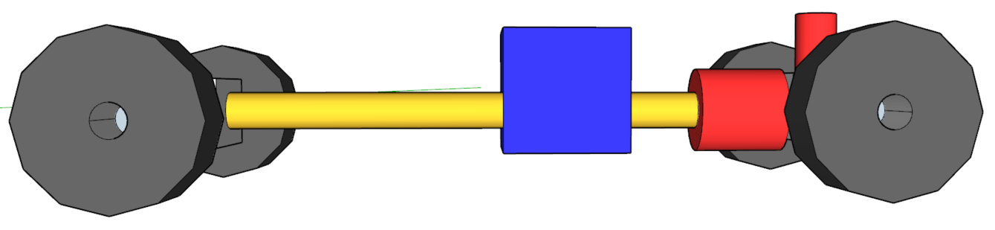
Etap 3/SteRoP_2019_HURA_ALMM_3/figures/3.png
