albert828/Sterowniki-robotow-P/Etap 3/SteRoP_2019_HURA_ALMM_3/figures/piny.png

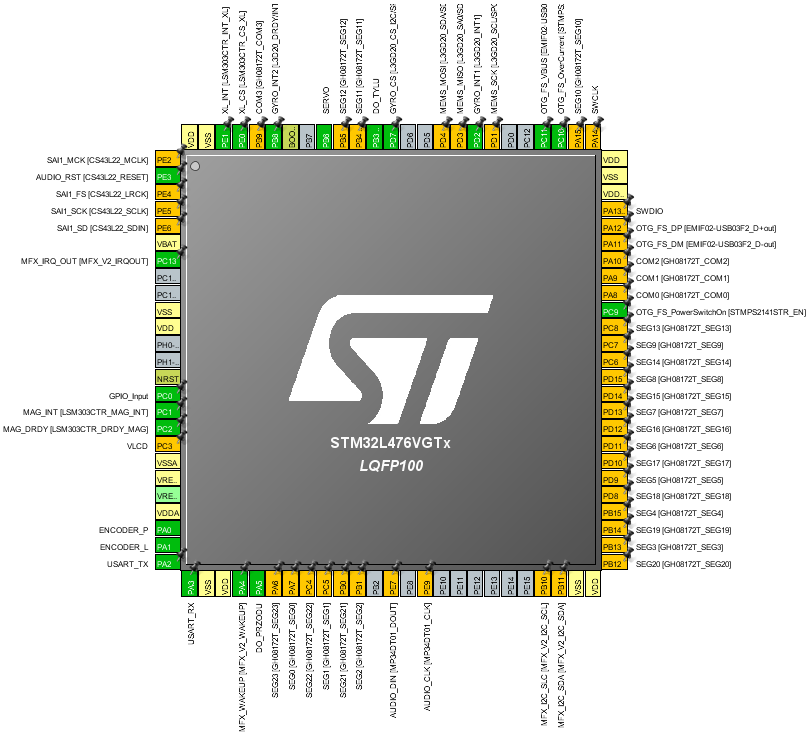
Etap 3/SteRoP_2019_HURA_ALMM_3/figures/piny.png
