albert828/Sterowniki-robotow-P/Software/STM32/IC_P/Inc/main.h

#define TIM5_PRESCALER 7999
#define TIM5_PERIOD 9999999
#define TIM2_PRESCALER 799
#define TIM2_PERIOD 254
#define TIM4_PERIOD 999
#define TIM4_PRESCALER 79
#define SAI1_MCK_Pin GPIO_PIN_2
#define SAI1_MCK_GPIO_Port GPIOE
#define AUDIO_RST_Pin GPIO_PIN_3
#define AUDIO_RST_GPIO_Port GPIOE
#define SAI1_FS_Pin GPIO_PIN_4
#define SAI1_FS_GPIO_Port GPIOE
#define SAI1_SCK_Pin GPIO_PIN_5
#define SAI1_SCK_GPIO_Port GPIOE
#define SAI1_SD_Pin GPIO_PIN_6
#define SAI1_SD_GPIO_Port GPIOE
#define MFX_IRQ_OUT_Pin GPIO_PIN_13
#define MFX_IRQ_OUT_GPIO_Port GPIOC
#define MAG_INT_Pin GPIO_PIN_1
#define MAG_INT_GPIO_Port GPIOC
#define MAG_DRDY_Pin GPIO_PIN_2
#define MAG_DRDY_GPIO_Port GPIOC
#define VLCD_Pin GPIO_PIN_3
#define VLCD_GPIO_Port GPIOC
#define ENCODER_P_Pin GPIO_PIN_0
#define ENCODER_P_GPIO_Port GPIOA
#define ENCODER_L_Pin GPIO_PIN_1
#define ENCODER_L_GPIO_Port GPIOA
#define USART_TX_Pin GPIO_PIN_2
#define USART_TX_GPIO_Port GPIOA
#define USART_RX_Pin GPIO_PIN_3
#define USART_RX_GPIO_Port GPIOA
#define MFX_WAKEUP_Pin GPIO_PIN_4
#define MFX_WAKEUP_GPIO_Port GPIOA
#define DO_PRZODU_Pin GPIO_PIN_5
#define DO_PRZODU_GPIO_Port GPIOA
#define SEG23_Pin GPIO_PIN_6
#define SEG23_GPIO_Port GPIOA
#define SEG0_Pin GPIO_PIN_7
#define SEG0_GPIO_Port GPIOA
#define SEG22_Pin GPIO_PIN_4
#define SEG22_GPIO_Port GPIOC
#define SEG1_Pin GPIO_PIN_5
#define SEG1_GPIO_Port GPIOC
#define SEG21_Pin GPIO_PIN_0
#define SEG21_GPIO_Port GPIOB
#define SEG2_Pin GPIO_PIN_1
#define SEG2_GPIO_Port GPIOB
#define AUDIO_DIN_Pin GPIO_PIN_7
#define AUDIO_DIN_GPIO_Port GPIOE
#define AUDIO_CLK_Pin GPIO_PIN_9
#define AUDIO_CLK_GPIO_Port GPIOE
#define MFX_I2C_SLC_Pin GPIO_PIN_10
#define MFX_I2C_SLC_GPIO_Port GPIOB
#define MFX_I2C_SDA_Pin GPIO_PIN_11
#define MFX_I2C_SDA_GPIO_Port GPIOB
#define SEG20_Pin GPIO_PIN_12
#define SEG20_GPIO_Port GPIOB
#define SEG3_Pin GPIO_PIN_13
#define SEG3_GPIO_Port GPIOB
#define SEG19_Pin GPIO_PIN_14
#define SEG19_GPIO_Port GPIOB
#define SEG4_Pin GPIO_PIN_15
#define SEG4_GPIO_Port GPIOB
#define SEG18_Pin GPIO_PIN_8
#define SEG18_GPIO_Port GPIOD
#define SEG5_Pin GPIO_PIN_9
#define SEG5_GPIO_Port GPIOD
#define SEG17_Pin GPIO_PIN_10
#define SEG17_GPIO_Port GPIOD
#define SEG6_Pin GPIO_PIN_11
#define SEG6_GPIO_Port GPIOD
#define SEG16_Pin GPIO_PIN_12
#define SEG16_GPIO_Port GPIOD
#define SEG7_Pin GPIO_PIN_13
#define SEG7_GPIO_Port GPIOD
#define SEG15_Pin GPIO_PIN_14
#define SEG15_GPIO_Port GPIOD
#define SEG8_Pin GPIO_PIN_15
#define SEG8_GPIO_Port GPIOD
#define SEG14_Pin GPIO_PIN_6
#define SEG14_GPIO_Port GPIOC
#define SEG9_Pin GPIO_PIN_7
#define SEG9_GPIO_Port GPIOC
#define SEG13_Pin GPIO_PIN_8
#define SEG13_GPIO_Port GPIOC
#define OTG_FS_PowerSwitchOn_Pin GPIO_PIN_9
#define OTG_FS_PowerSwitchOn_GPIO_Port GPIOC
#define COM0_Pin GPIO_PIN_8
#define COM0_GPIO_Port GPIOA
#define COM1_Pin GPIO_PIN_9
#define COM1_GPIO_Port GPIOA
#define COM2_Pin GPIO_PIN_10
#define COM2_GPIO_Port GPIOA
#define OTG_FS_DM_Pin GPIO_PIN_11
#define OTG_FS_DM_GPIO_Port GPIOA
#define OTG_FS_DP_Pin GPIO_PIN_12
#define OTG_FS_DP_GPIO_Port GPIOA
#define SWDIO_Pin GPIO_PIN_13
#define SWDIO_GPIO_Port GPIOA
#define SWCLK_Pin GPIO_PIN_14
#define SWCLK_GPIO_Port GPIOA
#define SEG10_Pin GPIO_PIN_15
#define SEG10_GPIO_Port GPIOA
#define OTG_FS_OverCurrent_Pin GPIO_PIN_10
#define OTG_FS_OverCurrent_GPIO_Port GPIOC
#define OTG_FS_VBUS_Pin GPIO_PIN_11
#define OTG_FS_VBUS_GPIO_Port GPIOC
#define MEMS_SCK_Pin GPIO_PIN_1
#define MEMS_SCK_GPIO_Port GPIOD
#define GYRO_INT1_Pin GPIO_PIN_2
#define GYRO_INT1_GPIO_Port GPIOD
#define MEMS_MISO_Pin GPIO_PIN_3
#define MEMS_MISO_GPIO_Port GPIOD
#define MEMS_MOSI_Pin GPIO_PIN_4
#define MEMS_MOSI_GPIO_Port GPIOD
#define GYRO_CS_Pin GPIO_PIN_7
#define GYRO_CS_GPIO_Port GPIOD
#define DO_TYLU_Pin GPIO_PIN_3
#define DO_TYLU_GPIO_Port GPIOB
#define SEG11_Pin GPIO_PIN_4
#define SEG11_GPIO_Port GPIOB
#define SEG12_Pin GPIO_PIN_5
#define SEG12_GPIO_Port GPIOB
#define GYRO_INT2_Pin GPIO_PIN_8
#define GYRO_INT2_GPIO_Port GPIOB
#define COM3_Pin GPIO_PIN_9
#define COM3_GPIO_Port GPIOB
#define XL_CS_Pin GPIO_PIN_0
#define XL_CS_GPIO_Port GPIOE
#define XL_INT_Pin GPIO_PIN_1
#define XL_INT_GPIO_Port GPIOE
