albert828/Sterowniki-robotow-P/Software/STM32/Jazda_skrecanie/Src/main.c

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

/* Includes ------------------------------------------------------------------*/
#include "main.h"
#include "dma.h"
#include "tim.h"
#include "usart.h"
#include "gpio.h"
#include "string.h"
#include "stdio.h"


/* USER CODE BEGIN PV */
volatile int flag, period;
int pwm_dutyL, pwm_dutyP, pwm_duty;
/* USER CODE END PV */

void SystemClock_Config(void);
/* USER CODE BEGIN 0 */
int _write(int file, char *s, int len)
{
	HAL_UART_Transmit_DMA(&huart2, (uint8_t*)s, len);
	return len;
}
void HAL_TIM_IC_CaptureCallback( TIM_HandleTypeDef *htim )
{
	if( htim == &htim5 )
	{
		if( htim->Channel == HAL_TIM_ACTIVE_CHANNEL_1)
		{
			period = __HAL_TIM_GET_COMPARE(&htim5, TIM_CHANNEL_1);
			__HAL_TIM_SET_COUNTER(&htim5, 0);
			flag = 1;
		}
	}
}


/* USER CODE END 0 */

/**
  * @brief  The application entry point.
  * @retval int
  */
int main(void)
{
  /* MCU Configuration--------------------------------------------------------*/

  /* Reset of all peripherals, Initializes the Flash interface and the Systick. */
  HAL_Init();

  /* USER CODE BEGIN Init */


  void Jazda(int pwm_duty)
  {
	  if(sign == '+' & axis == 'x')
	  {
		  pwm_duty = (pwm_duty + 1000) % 10000;
		  __HAL_TIM_SET_COMPARE(&htim2, TIM_CHANNEL_1, pwm_duty);
		  //HAL_GPIO_WritePin(DO_PRZODU_GPIO_Port,DO_PRZODU_Pin, GPIO_PIN_RESET);
	  }

	  if(sign == '-' & axis == 'x')
	  {
		  pwm_duty = (pwm_duty + 1000) % 10000;
		  __HAL_TIM_SET_COMPARE(&htim2, TIM_CHANNEL_1, pwm_duty);
		  //HAL_GPIO_WritePin(DO_TYLU_GPIO_Port, DO_TYLU_Pin, GPIO_PIN_RESET);
	  }
  }

  void Skrecanie(int value)
  {
	  if(axis == 'y')
	  {
		  htim4.Instance->CCR2 = value;
	  }
  }






  /* USER CODE END Init */

  /* Configure the system clock */
  SystemClock_Config();

  /* Initialize all configured peripherals */
  MX_GPIO_Init();
  MX_DMA_Init();
  MX_TIM5_Init();
  MX_USART2_UART_Init();
  /* USER CODE BEGIN 2 */
  flag = 0;
  pwm_dutyL = pwm_dutyP = 0;
  HAL_TIM_IC_Start_IT(&htim5 , TIM_CHANNEL_1);
  __HAL_TIM_SET_COMPARE(&htim2, TIM_CHANNEL_1, pwm_dutyL);
  __HAL_TIM_SET_COMPARE(&htim2, TIM_CHANNEL_1, pwm_dutyP);
  __HAL_TIM_SET_COMPARE(&htim4, TIM_CHANNEL_2, pwm_duty);
  HAL_TIM_PWM_Start(&htim2, TIM_CHANNEL_1); // jazda do przodu
  HAL_TIM_PWM_Start(&htim2, TIM_CHANNEL_2); // jazda do tylu
  HAL_TIM_PWM_Start(&htim4, TIM_CHANNEL_2); // skrecanie
  /* USER CODE END 2 */

  /* Infinite loop */
  /* USER CODE BEGIN WHILE */
  while (1)
  {
	 // HAL_GPIO_WritePin(DO_PRZODU_GPIO_Port,DO_PRZODU_Pin, GPIO_PIN_RESET);
	  //HAL_Delay(3000);
	  //HAL_GPIO_WritePin(DO_TYLU_GPIO_Port, DO_TYLU_Pin, GPIO_PIN_RESET);
    /* USER CODE END WHILE */
	  if(flag == 1)
	  {



		  HAL_GPIO_TogglePin (LD_R_GPIO_Port, LD_R_Pin );
		  printf( "Wykryto: %d \r \n", period/1000 );
		  flag = 0;
	  }
HAL_Delay(10);
    /* USER CODE BEGIN 3 */
  }
  /* USER CODE END 3 */
}

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
