albert828/Sterowniki-robotow-P/(commit log)

2019-03-11 Add Flow diagram, some improvements
2019-04-07 Split into stages
2019-05-06 Add UDP with serial between STM and ESP not correct
    [UDP_SR.ino, main.c]
2019-05-06 Add working UDP via UART (needs sync - not finished)
2019-05-07 Add working UDP by UART comunication with sync
2019-05-29 Add working serial into project on Interrupts
2019-05-29 Change serial interrupts into DMA
